comejv/ubac/hardware/BOM_Main Board_Schematic Main_2026-02-19.csv

No. | Quantity | Comment | Designator | Footprint | Value | Tolerance
1 | 2 | 100nF | C1,C3 | C0805 | 100nF | ±10%
2 | 1 | 1uF | C2 | C0805 | 1uF | ±10%
3 | 1 | 1729128 | CN1 | CONN-TH_2P-P5.08_1729128
4 | 1 | PM254V-11-03-H85 | H1 | HDR-TH_3P-P2.54-V-F
5 | 1 | MBT3904DW1T1G | Q1 | SOT-363_L2.0-W1.3-P0.65-LS2.1-TL
6 | 3 | 4.7kΩ | R1,R2,R18 | R0805 | 4.7kΩ | ±1%
7 | 1 | 220Ω | R3 | R0805 | 220Ω | ±1%
8 | 4 | 100kΩ | R4,R5,R6,R7 | R0805 | 100kΩ | ±1%
9 | 10 | 56kΩ | R8,R9,R10,R11,R12,R13,R14,R15,R16,R17 | R0805 | 56kΩ | ±0.1%
10 | 2 | 100Ω | R19,R20 | R0805 | 100Ω | ±1%
11 | 1 | 180Ω | R21 | R0805 | 180Ω | ±1%
12 | 1 | 1kΩ | R22 | R0805 | 1kΩ | ±5%
13 | 1 | GL5539 | R23 | RES-TH_L5.1-W4.3-P3.40-D0.5
14 | 1 | 10kΩ | R24 | R0805 | 10kΩ | ±1%
15 | 2 | ZX-PM2.54-1-20PY | U1,U2 | HDR-TH_20P-P2.54-V-F
16 | 1 | ADS1115IDGSR | U3 | MSOP-10_L3.0-W3.0-P0.50-LS5.0-BL
17 | 1 | CD74HC4067SM96 | U4 | SSOP-24_L8.1-W5.3-P0.65-LS7.8-BL
18 | 1 | HX FH254-02-10-W-H8.5 right angle pin header | U5 | HDR-TH_20P-P2.54-H-F-R2-C10-S2.54-W12.7
19 | 1 | DS18B20 | U6 | TO-92-3_L4.5-W3.5-P1.27-L |  | ±0.4℃
20 | 1 | XL-B2020RGBA-HF | U7 | LED-SMD_4P-L2.1-W2.1-P1.0-BL
21 | 1 | MX126-5.0-03P-GN01-Cu-S-A | U8 | CONN-TH_3P-P5.00_MAX_MX126-5.0-GN01-03P-CU-S-A
22 | 1 | DC-050-20 | U9 | DC-IN-SMD_DC-050-20A
23 | 1 | K7805-1000R3 | U10 | PWRM-TH_YLPTEC_K78XX-1000R3
