comejv/ubac/hardware/SCH_Schematic Main_2026-02-19.pdf

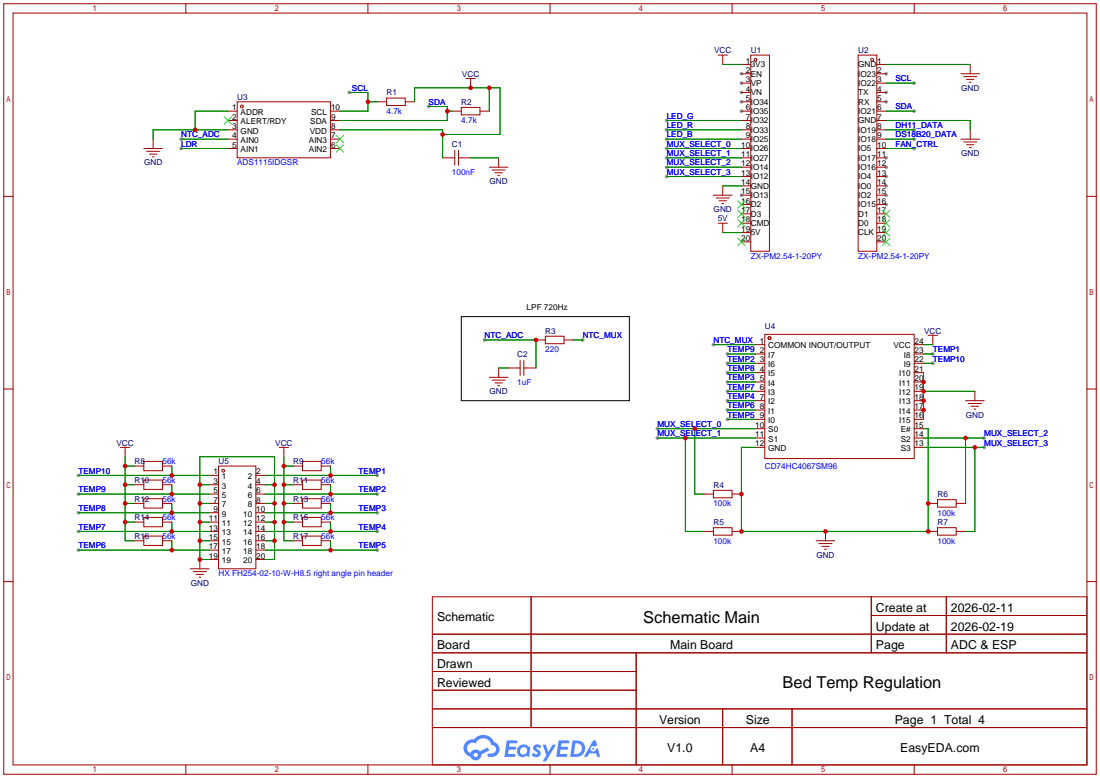
[picture p1: page 1]

Schematic | Schematic Main | Create at | 2026-02-11

Update at | 2026-02-19

Board | Main Board | Page | ADC & ESP
Drawn | | Bed Temp Regulation
Reviewed

Version | Size | Page 1 Total 4
V1.0 | A4 | EasyEDA.com

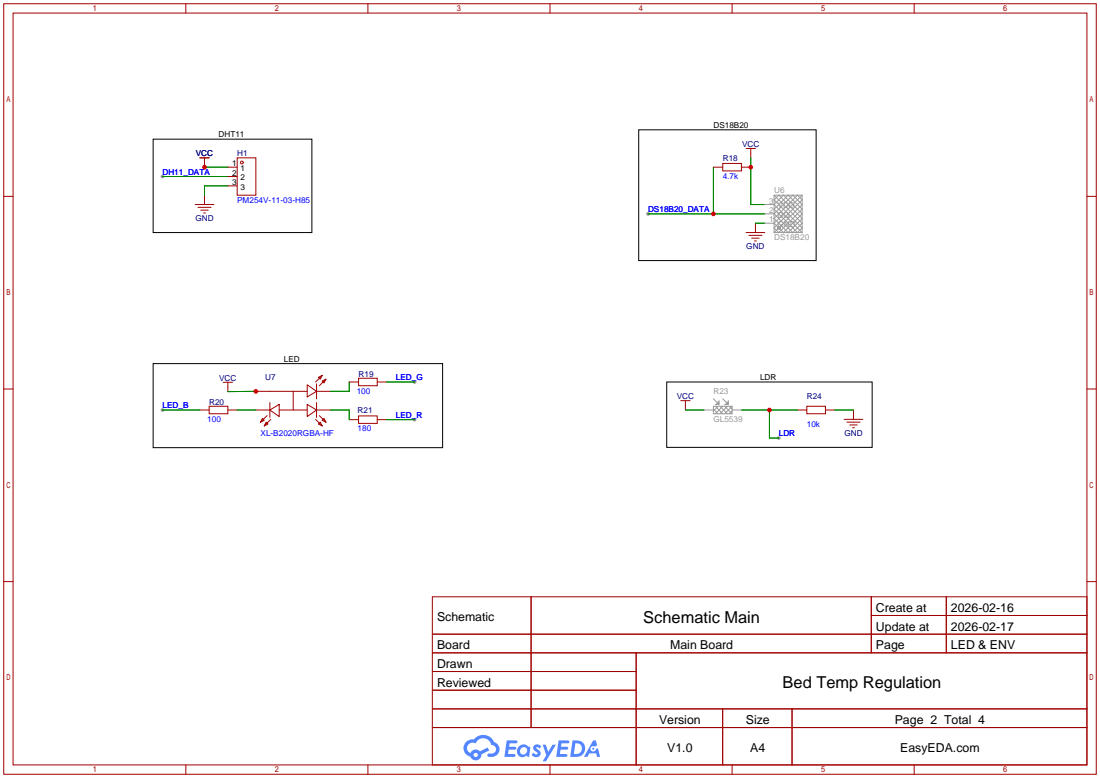
[picture p2: page 2]

Schematic | Schematic Main | Create at | 2026-02-16

Update at | 2026-02-17

Board | Main Board | Page | LED & ENV
Drawn | | Bed Temp Regulation
Reviewed

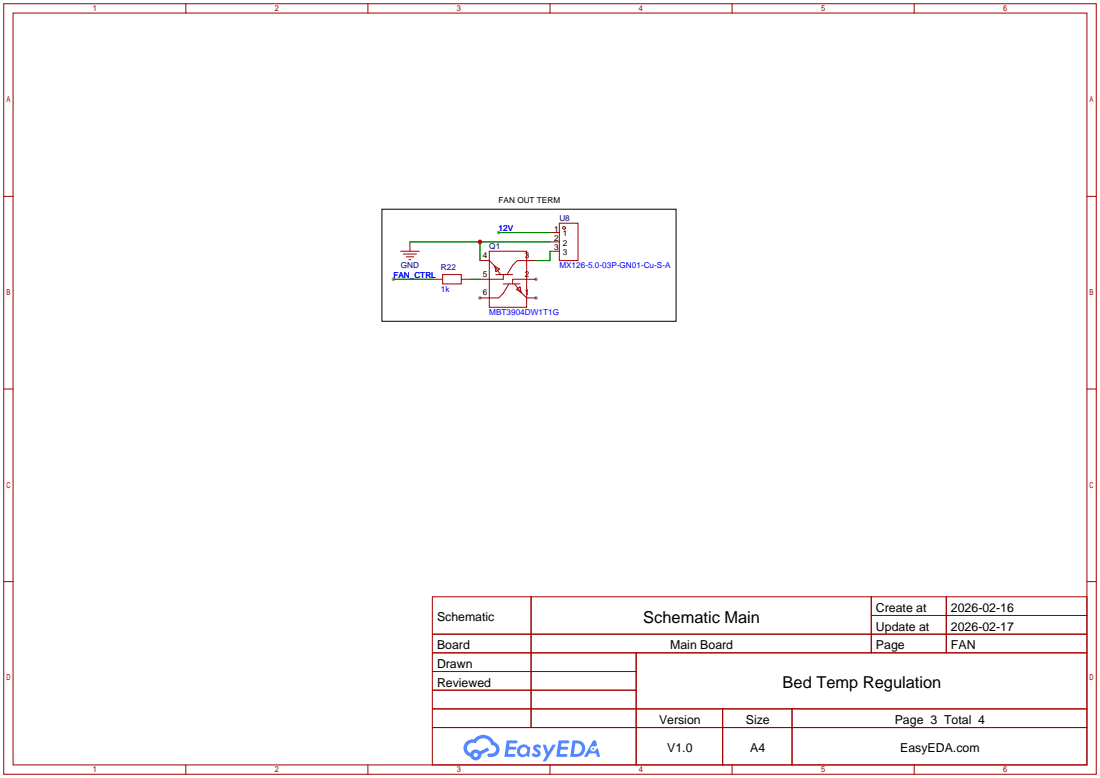
[picture p3: page 3]

Schematic | Schematic Main | Create at | 2026-02-16

Update at | 2026-02-17

Board | Main Board | Page | FAN
Drawn | | Bed Temp Regulation
Reviewed

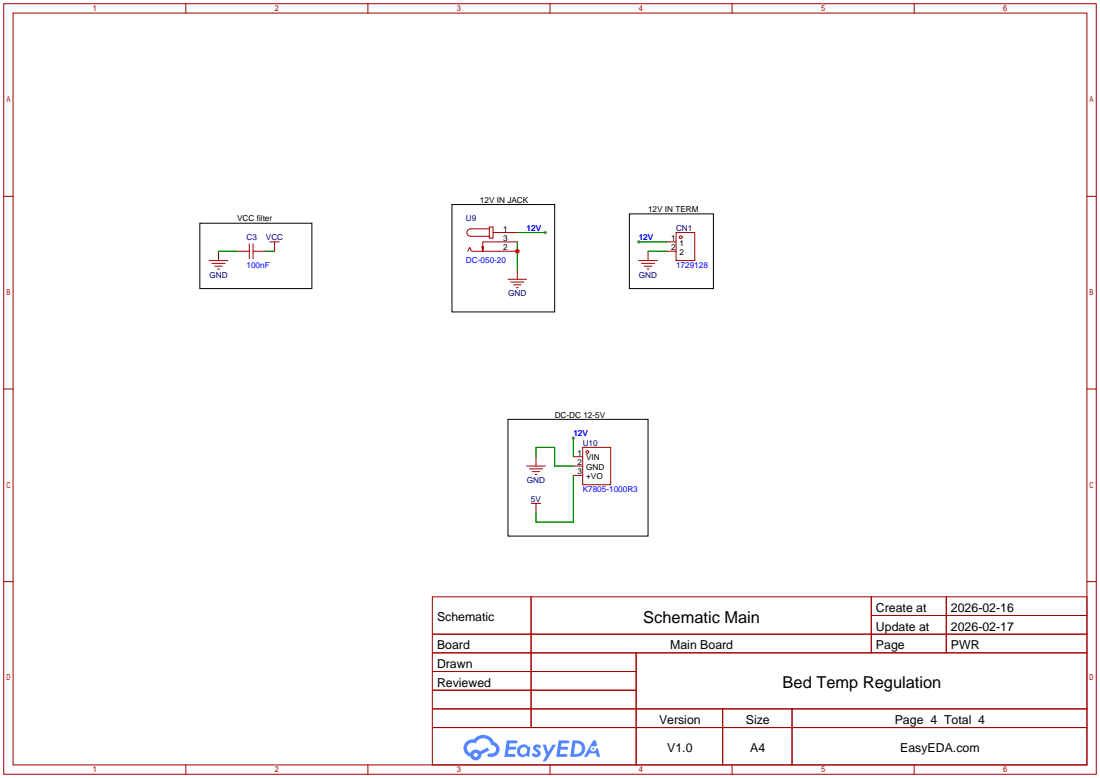
[picture p4: page 4]

Schematic | Schematic Main | Create at | 2026-02-16

Update at | 2026-02-17

Board | Main Board | Page | PWR
Drawn | | Bed Temp Regulation
Reviewed
