comejv/ubac/(list of files, drawings)

Other design files:
hardware/ProPrj_Bed Temp Regulation_2026-02-19.epro
