comejv/ubac/main/src/drivers/ntc_sensor.c

/*
 * UBAC: NTC Sensor Reading.
 * Copyright (C) 2026 Côme VINCENT
 *
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
 * You should have received a copy of the GNU General Public License
 * along with this program.  If not, see <https://www.gnu.org/licenses/>.
 */

#include "drivers/ntc_sensor.h"
#include "drivers/ads1115.h"
#include "drivers/mux.h"
#include "freertos/FreeRTOS.h"
#include "freertos/task.h"
#include <math.h>

// --- NTC Constants ---
#define R_DIVIDER 56000.0f
#define VREF_RAIL 3.3f   // Voltage supplying the NTC divider

// --- Steinhart-Hart Coefficients (R in ohms, T in kelvin) ---
#define SH_A 8.954641936e-4f
#define SH_B 2.034215141e-4f
#define SH_C 7.639241707e-8f

static float convert_raw_to_celsius(int16_t raw_adc)
{
  // Single-ended should be >= 0. Allow 0 (near GND) as valid.
  if (raw_adc < 0)
  {
    return NTC_INVALID_TEMP;
  }

  float voltage = (float) raw_adc * ADS_LSB_4V;

  // Guard: divider math explodes near VREF_RAIL
  if (voltage <= 0.001F || voltage >= (VREF_RAIL - 0.01F))
  {
    return NTC_INVALID_TEMP;
  }

  float r_ntc = (voltage * R_DIVIDER) / (VREF_RAIL - voltage);
  if (r_ntc <= 0.0F)
  {
    return NTC_INVALID_TEMP;
  }

  float lnR = logf(r_ntc);
  float invT = SH_A + (SH_B * lnR) + (SH_C * lnR * lnR * lnR);
  if (invT <= 0.0F)
  {
    return NTC_INVALID_TEMP;
  }

  float temp_k = 1.0F / invT;
  return temp_k - 273.15F;
}

esp_err_t ntc_get_temp_celsius(uint8_t channel, float *out_temp)
{
  if (!out_temp)
    return ESP_ERR_INVALID_ARG;

  mux_set_channel(channel);

  // Short delay for voltage stabilization after mux switch
  vTaskDelay(pdMS_TO_TICKS(10));

  // Trigger and read single-shot
  int16_t raw_val = 0;
  esp_err_t err = ads1115_read_raw(&raw_val, ADS1115_MUX_AIN0);
  if (err != ESP_OK)
  {
    return err;
  }

  *out_temp = convert_raw_to_celsius(raw_val);
  return (*out_temp == NTC_INVALID_TEMP) ? ESP_FAIL : ESP_OK;
}
