comejv/ubac/main/src/app/ntc_history.c

/*
 * UBAC: Temperature History Management.
 * Copyright (C) 2026 Côme VINCENT
 *
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
 * You should have received a copy of the GNU General Public License
 * along with this program.  If not, see <https://www.gnu.org/licenses/>.
 */

#include "app/ntc_history.h"

#include "esp_log.h"
#include "esp_partition.h"
#include "esp_rom_crc.h"
#include "freertos/FreeRTOS.h"
#include "freertos/semphr.h"

#include <inttypes.h>
#include <math.h>
#include <stddef.h>
#include <string.h>
#include <time.h>

#define STORAGE_PARTITION_LABEL   "storage"
#define STORAGE_PARTITION_SUBTYPE 0x99

#define SECTOR_SIZE     4096u
#define SECTOR_HDR_SIZE 64u

// On-flash record layout is 64 bytes.
#define RECORD_SIZE 64u

// Compute dynamic padding required for exactly 64 bytes.
#define RECORD_PAYLOAD_SIZE (12 + (2 * NTC_CHANNELS_COUNT) + 2 + 2)
#if RECORD_PAYLOAD_SIZE > 64
#error "NTC_CHANNELS_COUNT too large for 64-byte record"
#endif
#define RECORD_PADDING (64 - RECORD_PAYLOAD_SIZE)

#define RECORDS_PER_SECTOR ((SECTOR_SIZE - SECTOR_HDR_SIZE) / RECORD_SIZE)
#define RAM_BUFFER_RECORDS 16

#define SECTOR_MAGIC   0x53454354u   // 'SECT'
#define FORMAT_VERSION 2u

static const char *TAG = "NTC_HISTORY";

typedef struct __attribute__((packed))
{
  uint32_t magic;       // SECTOR_MAGIC
  uint32_t version;     // FORMAT_VERSION
  uint32_t seq_start;   // sequence number for first record in sector
  uint32_t hdr_crc32;   // CRC32 over version+seq_start
  uint8_t pad[SECTOR_HDR_SIZE - 16];
} sector_hdr_t;

_Static_assert(sizeof(sector_hdr_t) == SECTOR_HDR_SIZE, "sector_hdr_t size");

typedef struct __attribute__((packed))
{
  uint32_t seq;         // monotonic
  uint32_t timestamp;   // unix seconds
  int16_t temps_cC[NTC_CHANNELS_COUNT];
  int16_t room_temp_cC;
  int16_t humidity_cRH;
#if RECORD_PADDING > 0
  uint8_t pad[RECORD_PADDING];
#endif
  uint32_t rec_crc32;   // CRC over everything up to this struct member
} record_flash_t;

_Static_assert(sizeof(record_flash_t) == RECORD_SIZE, "record_flash_t size");

typedef struct
{
  uint32_t timestamp;
  int16_t temps_cC[NTC_CHANNELS_COUNT];
  int16_t room_temp_cC;
  int16_t humidity_cRH;
} record_ram_t;

typedef struct
{
  uint32_t sector_idx;
  uint32_t seq_start;
} sector_info_t;

static const esp_partition_t *s_part = NULL;
static SemaphoreHandle_t s_lock = NULL;

static uint32_t s_sector_count = 0;
static uint32_t s_cur_sector = 0;
static uint32_t s_cur_slot = 0;
static uint32_t s_last_seq = 0;
static bool s_ready = false;

static record_ram_t s_ram_buf[RAM_BUFFER_RECORDS];
static size_t s_ram_count = 0;

static uint32_t compute_crc32(const void *data, size_t len)
{
  return esp_rom_crc32_le(0, (const uint8_t *) data, len);
}

static uint32_t get_sector_offset(uint32_t sector_idx)
{
  return sector_idx * SECTOR_SIZE;
}

static uint32_t get_record_offset(uint32_t sector_idx, uint32_t slot_idx)
{
  return get_sector_offset(sector_idx) + SECTOR_HDR_SIZE +
         (slot_idx * RECORD_SIZE);
}

static int16_t float_to_cC(float temp_c)
{
  if (isnan(temp_c) || isinf(temp_c))
  {
    return INT16_MIN;
  }

  long v = lroundf(temp_c * (float) NTC_TEMP_SCALE);
  if (v > INT16_MAX)
    return INT16_MAX;
  if (v < INT16_MIN + 1)
    return INT16_MIN + 1;
  return (int16_t) v;
}

static bool read_sector_hdr(uint32_t sector_idx, sector_hdr_t *out_hdr)
{
  if (esp_partition_read(s_part, get_sector_offset(sector_idx), out_hdr,
                         sizeof(*out_hdr)) != ESP_OK)
  {
    return false;
  }

  if (out_hdr->magic != SECTOR_MAGIC || out_hdr->version != FORMAT_VERSION)
  {
    return false;
  }

  uint32_t expected = compute_crc32(&out_hdr->version, 8);
  return expected == out_hdr->hdr_crc32;
}

static bool read_record(uint32_t sector_idx, uint32_t slot_idx,
                        record_flash_t *out_rec)
{
  return esp_partition_read(s_part, get_record_offset(sector_idx, slot_idx),
                            out_rec, sizeof(*out_rec)) == ESP_OK;
}

static bool record_is_empty(const record_flash_t *r)
{
  return r->seq == 0xFFFFFFFFu;
}

static bool record_is_valid(const record_flash_t *r)
{
  if (r->seq == 0 || r->seq == 0xFFFFFFFFu)
  {
    return false;
  }

  uint32_t expected = compute_crc32(r, offsetof(record_flash_t, rec_crc32));
  return expected == r->rec_crc32;
}

static esp_err_t write_sector_hdr(uint32_t sector_idx, uint32_t seq_start)
{
  sector_hdr_t hdr;
  memset(&hdr, 0xFF, sizeof(hdr));

  hdr.magic = SECTOR_MAGIC;
  hdr.version = FORMAT_VERSION;
  hdr.seq_start = seq_start;
  hdr.hdr_crc32 = compute_crc32(&hdr.version, 8);

  return esp_partition_write(s_part, get_sector_offset(sector_idx), &hdr,
                             sizeof(hdr));
}

static size_t collect_sectors(sector_info_t *out, size_t max)
{
  size_t n = 0;
  for (uint32_t i = 0; i < s_sector_count && n < max; i++)
  {
    sector_hdr_t hdr;
    if (!read_sector_hdr(i, &hdr))
    {
      continue;
    }
    out[n++] = (sector_info_t) {.sector_idx = i, .seq_start = hdr.seq_start};
  }
  return n;
}

static void sort_sectors_by_seq_start(sector_info_t *s, size_t n)
{
  for (size_t i = 0; i < n; i++)
  {
    size_t best = i;
    for (size_t j = i + 1; j < n; j++)
    {
      if (s[j].seq_start < s[best].seq_start)
        best = j;
    }
    if (best != i)
    {
      sector_info_t tmp = s[i];
      s[i] = s[best];
      s[best] = tmp;
    }
  }
}

static esp_err_t advance_sector(void)
{
  uint32_t next = (s_cur_sector + 1) % s_sector_count;

  esp_err_t err =
      esp_partition_erase_range(s_part, get_sector_offset(next), SECTOR_SIZE);
  if (err != ESP_OK)
    return err;

  err = write_sector_hdr(next, s_last_seq + 1);
  if (err != ESP_OK)
    return err;

  s_cur_sector = next;
  s_cur_slot = 0;
  return ESP_OK;
}

static void scan_current_sector_tail(void)
{
  for (uint32_t slot = 0; slot < RECORDS_PER_SECTOR; slot++)
  {
    record_flash_t r;
    if (!read_record(s_cur_sector, slot, &r))
    {
      s_cur_slot = RECORDS_PER_SECTOR;
      return;
    }

    if (record_is_empty(&r))
    {
      s_cur_slot = slot;
      return;
    }

    if (!record_is_valid(&r))
    {
      s_cur_slot = RECORDS_PER_SECTOR;
      return;
    }

    if (r.seq > s_last_seq)
    {
      s_last_seq = r.seq;
    }
  }

  s_cur_slot = RECORDS_PER_SECTOR;
}

static esp_err_t write_one_record(uint32_t timestamp,
                                  const int16_t temps_cC[NTC_CHANNELS_COUNT],
                                  int16_t room_temp_cC,
                                  int16_t humidity_cRH)
{
  if (s_cur_slot >= RECORDS_PER_SECTOR)
  {
    esp_err_t err = advance_sector();
    if (err != ESP_OK)
      return err;
  }

  record_flash_t rec;
  memset(&rec, 0xFF, sizeof(rec));

  rec.seq = s_last_seq + 1;
  rec.timestamp = timestamp;
  memcpy(rec.temps_cC, temps_cC, sizeof(rec.temps_cC));
  rec.room_temp_cC = room_temp_cC;
  rec.humidity_cRH = humidity_cRH;
  rec.rec_crc32 = compute_crc32(&rec, offsetof(record_flash_t, rec_crc32));

  uint32_t off = get_record_offset(s_cur_sector, s_cur_slot);

  esp_err_t err = esp_partition_write(s_part, off, &rec, sizeof(rec));
  if (err != ESP_OK)
    return err;

  s_last_seq = rec.seq;
  s_cur_slot++;
  return ESP_OK;
}

// Caller must hold s_lock!
static esp_err_t flush_locked(void)
{
  esp_err_t last_err = ESP_OK;
  size_t i;
  for (i = 0; i < s_ram_count; i++)
  {
    esp_err_t err = write_one_record(s_ram_buf[i].timestamp, s_ram_buf[i].temps_cC,
                                     s_ram_buf[i].room_temp_cC, s_ram_buf[i].humidity_cRH);
    if (err != ESP_OK)
    {
      ESP_LOGE(TAG, "write_one_record failed: %s", esp_err_to_name(err));
      last_err = err;
      break;
    }
  }

  if (i > 0)
  {
    size_t remaining = s_ram_count - i;
    if (remaining > 0)
    {
      memmove(s_ram_buf, &s_ram_buf[i], remaining * sizeof(record_ram_t));
    }
    s_ram_count = remaining;
  }
  return last_err;
}

esp_err_t ntc_history_init(void)
{
  s_part = esp_partition_find_first(ESP_PARTITION_TYPE_DATA,
                                    STORAGE_PARTITION_SUBTYPE,
                                    STORAGE_PARTITION_LABEL);
  if (!s_part)
  {
    ESP_LOGE(TAG, "Could not find storage partition, will not log NTC history");
    s_ready = false;
    return ESP_ERR_NOT_FOUND;
  }

  if (s_part->erase_size != SECTOR_SIZE)
  {
    ESP_LOGE(TAG, "Unexpected erase size=%" PRIu32, s_part->erase_size);
    s_ready = false;
    return ESP_ERR_INVALID_STATE;
  }

  s_sector_count = s_part->size / SECTOR_SIZE;
  if (s_sector_count == 0)
  {
    ESP_LOGE(TAG, "Partition too small");
    s_ready = false;
    return ESP_ERR_INVALID_SIZE;
  }

  if (!s_lock)
  {
    s_lock = xSemaphoreCreateMutex();
  }

  xSemaphoreTake(s_lock, portMAX_DELAY);

  bool found_any = false;
  uint32_t best_sector = 0;
  uint32_t best_seq_start = 0;

  for (uint32_t i = 0; i < s_sector_count; i++)
  {
    sector_hdr_t hdr;
    if (!read_sector_hdr(i, &hdr))
      continue;

    if (!found_any || hdr.seq_start > best_seq_start)
    {
      found_any = true;
      best_sector = i;
      best_seq_start = hdr.seq_start;
    }
  }

  s_last_seq = 0;
  s_cur_sector = 0;
  s_cur_slot = 0;

  if (!found_any)
  {
    ESP_LOGI(TAG, "No valid log (format v%u); initializing sector 0",
             (unsigned) FORMAT_VERSION);

    esp_err_t err = esp_partition_erase_range(s_part, get_sector_offset(0), SECTOR_SIZE);
    if (err != ESP_OK)
    {
      xSemaphoreGive(s_lock);
      return err;
    }
    err = write_sector_hdr(0, 1);
    if (err != ESP_OK)
    {
      xSemaphoreGive(s_lock);
      return err;
    }
  }
  else
  {
    s_cur_sector = best_sector;
    s_last_seq = best_seq_start - 1;
    scan_current_sector_tail();

    if (s_cur_slot >= RECORDS_PER_SECTOR)
    {
      esp_err_t err = advance_sector();
      if (err != ESP_OK)
      {
        xSemaphoreGive(s_lock);
        return err;
      }
    }
  }

  s_ready = true;

  ESP_LOGI(TAG,
           "Init ok: sectors=%" PRIu32 " records/sector=%u capacity=%u "
           "cur_sector=%" PRIu32 " cur_slot=%" PRIu32 " last_seq=%" PRIu32,
           s_sector_count, (unsigned) RECORDS_PER_SECTOR,
           (unsigned) ntc_history_get_capacity(), s_cur_sector, s_cur_slot,
           s_last_seq);

  xSemaphoreGive(s_lock);
  return ESP_OK;
}

esp_err_t ntc_history_add_record(const float temps[NTC_CHANNELS_COUNT], float room_temp, float humidity)
{
  if (!s_ready)
    return ESP_ERR_INVALID_STATE;

  record_ram_t r;
  r.timestamp = (uint32_t) time(NULL);
  for (int i = 0; i < NTC_CHANNELS_COUNT; i++)
  {
    r.temps_cC[i] = float_to_cC(temps[i]);
  }
  r.room_temp_cC = float_to_cC(room_temp);
  r.humidity_cRH = float_to_cC(humidity);

  xSemaphoreTake(s_lock, portMAX_DELAY);

  esp_err_t err = ESP_OK;
  if (s_ram_count >= RAM_BUFFER_RECORDS)
  {
    err = flush_locked();
  }

  if (s_ram_count < RAM_BUFFER_RECORDS)
  {
    s_ram_buf[s_ram_count++] = r;
  }

  if (s_ram_count >= RAM_BUFFER_RECORDS)
  {
    err = flush_locked();
  }

  xSemaphoreGive(s_lock);
  return err;
}

esp_err_t ntc_history_flush(void)
{
  if (!s_ready)
    return ESP_ERR_INVALID_STATE;

  xSemaphoreTake(s_lock, portMAX_DELAY);
  esp_err_t err = flush_locked();
  xSemaphoreGive(s_lock);
  return err;
}

size_t ntc_history_get_capacity(void)
{
  if (!s_part)
    return 0;
  return (size_t) s_sector_count * (size_t) RECORDS_PER_SECTOR;
}

size_t ntc_history_iterate(uint32_t since_ts, size_t max,
                           ntc_history_iter_cb_t cb, void *ctx)
{
  if (!s_ready)
    return 0;
  if (max == 0)
    max = (size_t) -1;

  xSemaphoreTake(s_lock, portMAX_DELAY);

  sector_info_t *sectors = malloc(s_sector_count * sizeof(sector_info_t));
  if (!sectors)
  {
    xSemaphoreGive(s_lock);
    return 0;
  }

  size_t nsec = collect_sectors(sectors, s_sector_count);
  sort_sectors_by_seq_start(sectors, nsec);

  xSemaphoreGive(s_lock);

  size_t emitted = 0;

  uint8_t *sec_buf = malloc(SECTOR_SIZE);
  if (!sec_buf)
  {
    free(sectors);
    return 0;
  }

  for (size_t si = 0; si < nsec; si++)
  {
    uint32_t sector = sectors[si].sector_idx;

    if (esp_partition_read(s_part, get_sector_offset(sector), sec_buf,
                           SECTOR_SIZE) != ESP_OK)
    {
      continue;
    }

    for (uint32_t slot = 0; slot < RECORDS_PER_SECTOR; slot++)
    {
      record_flash_t *rf = (record_flash_t *) (sec_buf + SECTOR_HDR_SIZE +
                                               (slot * RECORD_SIZE));

      if (record_is_empty(rf) || !record_is_valid(rf))
      {
        break;
      }

      if (since_ts != 0 && rf->timestamp < since_ts)
        continue;

      ntc_record_t r;
      r.timestamp = rf->timestamp;
      memcpy(r.temps_cC, rf->temps_cC, sizeof(r.temps_cC));
      r.room_temp_cC = rf->room_temp_cC;
      r.humidity_cRH = rf->humidity_cRH;

      if (cb && !cb(&r, ctx))
      {
        goto done;
      }

      emitted++;
      if (emitted >= max)
        goto done;
    }
  }

done:
  free(sec_buf);
  free(sectors);
  return emitted;
}

typedef struct
{
  size_t count;
} count_ctx_t;

static bool count_cb(const ntc_record_t *rec, void *ctx)
{
  (void) rec;
  count_ctx_t *c = (count_ctx_t *) ctx;
  c->count++;
  return true;
}

typedef struct
{
  ntc_record_t *out;
  size_t max;
  size_t skip;
  size_t written;
  size_t seen;
} copy_ctx_t;

static bool copy_cb(const ntc_record_t *rec, void *ctx)
{
  copy_ctx_t *c = (copy_ctx_t *) ctx;

  if (c->seen++ < c->skip)
    return true;
  if (c->written >= c->max)
    return false;

  c->out[c->written++] = *rec;
  return c->written < c->max;
}

size_t ntc_history_get_records(ntc_record_t *out_records, size_t max_records)
{
  if (!s_ready || !out_records || max_records == 0)
    return 0;

  count_ctx_t cc = {.count = 0};
  (void) ntc_history_iterate(0, 0, count_cb, &cc);

  size_t total = cc.count;
  size_t skip = (total > max_records) ? (total - max_records) : 0;

  copy_ctx_t cx = {
      .out = out_records,
      .max = max_records,
      .skip = skip,
      .written = 0,
      .seen = 0,
  };

  (void) ntc_history_iterate(0, 0, copy_cb, &cx);
  return cx.written;
}

esp_err_t ntc_history_erase_all(void)
{
  if (!s_part)
    return ESP_ERR_INVALID_STATE;
  if (!s_lock)
    s_lock = xSemaphoreCreateMutex();

  xSemaphoreTake(s_lock, portMAX_DELAY);

  esp_err_t err = esp_partition_erase_range(s_part, 0, s_part->size);
  if (err != ESP_OK)
  {
    xSemaphoreGive(s_lock);
    return err;
  }

  err = write_sector_hdr(0, 1);
  if (err != ESP_OK)
  {
    xSemaphoreGive(s_lock);
    return err;
  }

  s_cur_sector = 0;
  s_cur_slot = 0;
  s_last_seq = 0;
  s_ram_count = 0;
  s_ready = true;

  xSemaphoreGive(s_lock);
  return ESP_OK;
}
