comejv/ubac/main/src/web_server.c

/*
 * UBAC:web_server.c for ESP32 to serve web pages.
 * Copyright (C) 2026 Côme VINCENT
 *
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
 * You should have received a copy of the GNU General Public License
 * along with this program.  If not, see <https://www.gnu.org/licenses/>.
 */

#include "web_server.h"
#include "esp_http_server.h"
#include "esp_log.h"
#include "esp_system.h"
#include "esp_wifi.h"
#include "ntc_history.h"
#include "wifi_app.h"
#include <inttypes.h>
#include <math.h>
#include <stddef.h>
#include <string.h>
#include <sys/param.h>
#include <sys/time.h>

static const char *TAG = "WEB_SERVER";
static httpd_handle_t server = NULL;

/* HTML Content */
extern const uint8_t config_html_start[] asm("_binary_config_html_start");
extern const uint8_t config_html_end[] asm("_binary_config_html_end");

extern const uint8_t dashboard_html_start[] asm("_binary_dashboard_html_start");
extern const uint8_t dashboard_html_end[] asm("_binary_dashboard_html_end");

/* Handler for the root URL */
static esp_err_t index_get_handler(httpd_req_t *req)
{
  httpd_resp_set_type(req, "text/html");

  // Check if we are connected to STA
  wifi_ap_record_t ap_info;
  if (esp_wifi_sta_get_ap_info(&ap_info) == ESP_OK)
  {
    const char *resp = (const char *) dashboard_html_start;
    size_t resp_len = strlen(resp);
    size_t chunk_size = 2048;
    size_t offset = 0;

    while (offset < resp_len)
    {
      size_t len = resp_len - offset;
      if (len > chunk_size)
      {
        len = chunk_size;
      }
      if (httpd_resp_send_chunk(req, resp + offset, len) != ESP_OK)
      {
        return ESP_FAIL;
      }
      offset += len;
    }
    httpd_resp_send_chunk(req, NULL, 0);
  }
  else
  {
    httpd_resp_send(req, (const char *) config_html_start, HTTPD_RESP_USE_STRLEN);
  }
  return ESP_OK;
}

/* Handler for /history.json */
typedef struct
{
  httpd_req_t *req;
  size_t count;
  size_t skip;
  size_t seen;
} stream_ctx_t;

static bool history_stream_cb(const ntc_record_t *rec, void *ctx)
{
  stream_ctx_t *c = (stream_ctx_t *) ctx;

  if (c->seen < c->skip)
  {
    c->seen++;
    return true;
  }

  if (c->count == 0)
  {
    httpd_resp_sendstr_chunk(c->req, "[");
  }
  else
  {
    httpd_resp_sendstr_chunk(c->req, ",");
  }

  char buf[256];
  int len = snprintf(
      buf, sizeof(buf),
      "{\"t\":%" PRIu32 ",\"s\":%d,"
      "\"v\":[%d,%d,%d,%d,%d,%d,%d,%d,%d,%d]}",
      rec->timestamp, NTC_TEMP_SCALE, rec->temps_cC[0],
      rec->temps_cC[1], rec->temps_cC[2], rec->temps_cC[3],
      rec->temps_cC[4], rec->temps_cC[5], rec->temps_cC[6],
      rec->temps_cC[7], rec->temps_cC[8], rec->temps_cC[9]);

  httpd_resp_send_chunk(c->req, buf, len);
  c->count++;

  return true;
}

static esp_err_t history_get_handler(httpd_req_t *req)
{
  httpd_resp_set_type(req, "application/json");

  stream_ctx_t ctx = {
      .req = req,
      .count = 0,
      .skip = 0,
      .seen = 0,
  };

  size_t max = 1024;

  size_t actual_total = ntc_history_iterate(0, 0, NULL, NULL);
  if (actual_total > max)
  {
    ctx.skip = actual_total - max;
  }

  ntc_history_iterate(0, 0, history_stream_cb, &ctx);

  if (ctx.count == 0)
  {
    httpd_resp_send(req, "[]", 2);
  }
  else
  {
    httpd_resp_sendstr_chunk(req, "]");
    httpd_resp_send_chunk(req, NULL, 0);
  }

  return ESP_OK;
}

/* Handler for the scan URL */
static esp_err_t scan_get_handler(httpd_req_t *req)
{
  char *json = wifi_app_scan();
  if (json)
  {
    httpd_resp_set_type(req, "application/json");
    httpd_resp_send(req, json, HTTPD_RESP_USE_STRLEN);
    free(json);
  }
  else
  {
    httpd_resp_send_500(req);
  }
  return ESP_OK;
}

/* Async Connection Task */
typedef struct
{
  char ssid[32];
  char password[64];
} wifi_creds_t;

static void connect_task(void *pvParameters)
{
  wifi_creds_t *creds = (wifi_creds_t *) pvParameters;
  vTaskDelay(pdMS_TO_TICKS(1000));   // Delay to allow HTTP response to flush
  wifi_app_connect_sta(creds->ssid, creds->password);
  free(creds);
  vTaskDelete(NULL);
}

/* Handler for the connect POST */
static esp_err_t connect_post_handler(httpd_req_t *req)
{
  char buf[100];
  int ret;
  size_t remaining = req->content_len;

  if (remaining >= sizeof(buf))
  {
    httpd_resp_send_500(req);
    return ESP_FAIL;
  }

  ret = httpd_req_recv(req, buf, remaining);
  if (ret <= 0)
  {
    if (ret == HTTPD_SOCK_ERR_TIMEOUT)
    {
      httpd_resp_send_408(req);
    }
    return ESP_FAIL;
  }
  buf[ret] = '\0';

  wifi_creds_t *creds = malloc(sizeof(wifi_creds_t));
  if (!creds)
  {
    httpd_resp_send_500(req);
    return ESP_FAIL;
  }
  memset(creds, 0, sizeof(wifi_creds_t));

  char *ssid_ptr = strstr(buf, "ssid=");
  char *pass_ptr = strstr(buf, "password=");

  if (ssid_ptr)
  {
    ssid_ptr += 5;
    char *end = strchr(ssid_ptr, '&');
    if (!end)
      end = buf + strlen(buf);
    int len = MIN(end - ssid_ptr, sizeof(creds->ssid) - 1);
    strncpy(creds->ssid, ssid_ptr, len);
  }

  if (pass_ptr)
  {
    pass_ptr += 9;
    char *end = strchr(pass_ptr, '&');
    if (!end)
      end = buf + strlen(buf);
    int len = MIN(end - pass_ptr, sizeof(creds->password) - 1);
    strncpy(creds->password, pass_ptr, len);
  }

  ESP_LOGI(TAG, "Received Connect Request: SSID='%s'", creds->ssid);

  httpd_resp_send(req, "Connecting... Please reconnect to the new network.", HTTPD_RESP_USE_STRLEN);

  // Spawn task to handle connection
  xTaskCreate(connect_task, "connect_task", 4096, creds, 5, NULL);

  return ESP_OK;
}

/* Handler for /fake_history.json */
static esp_err_t fake_history_get_handler(httpd_req_t *req)
{
  httpd_resp_set_type(req, "application/json");
  httpd_resp_sendstr_chunk(req, "[");

  uint32_t now = (uint32_t) time(NULL);
  if (now < 1700000000)
    now = 1739980800;   // Fallback to Feb 2025 if RTC not set

  for (int i = 0; i < 100; i++)
  {
    uint32_t t = now - (100 - i) * 120;
    char buf[256];
    int vals[NTC_CHANNELS_COUNT];

    for (int ch = 0; ch < NTC_CHANNELS_COUNT; ch++)
    {
      float base = 25.0f + ch * 2.0f;
      float amplitude = 5.0f;
      float val = base + amplitude * sinf((float) (t % 3600) / 3600.0f * 2.0f * M_PI + (ch * 0.5f));
      vals[ch] = (int) (val * NTC_TEMP_SCALE);
    }

    int len = snprintf(
        buf, sizeof(buf),
        "%s{\"t\":%" PRIu32 ",\"s\":%d,\"v\":[%d,%d,%d,%d,%d,%d,%d,%d,%d,%d]}",
        (i == 0) ? "" : ",", t, NTC_TEMP_SCALE,
        vals[0], vals[1], vals[2], vals[3], vals[4],
        vals[5], vals[6], vals[7], vals[8], vals[9]);

    httpd_resp_send_chunk(req, buf, len);
  }

  httpd_resp_sendstr_chunk(req, "]");
  httpd_resp_send_chunk(req, NULL, 0);

  return ESP_OK;
}

/* Handler for the reset wifi POST */
static esp_err_t reset_wifi_post_handler(httpd_req_t *req)
{
  ESP_LOGI(TAG, "Clearing WiFi Station credentials and Restarting...");
  httpd_resp_send(req, "OK. WiFi credentials cleared. Restarting...", 44);

  vTaskDelay(pdMS_TO_TICKS(1000));

  // Clear only STA config instead of full restore
  wifi_config_t wifi_config = {0};
  esp_wifi_set_config(WIFI_IF_STA, &wifi_config);

  esp_restart();
  return ESP_OK;
}

static const httpd_uri_t index_uri = {
    .uri = "/",
    .method = HTTP_GET,
    .handler = index_get_handler,
    .user_ctx = NULL};

static const httpd_uri_t history_uri = {
    .uri = "/history.json",
    .method = HTTP_GET,
    .handler = history_get_handler,
    .user_ctx = NULL};

static const httpd_uri_t fake_history_uri = {
    .uri = "/fake_history.json",
    .method = HTTP_GET,
    .handler = fake_history_get_handler,
    .user_ctx = NULL};

static const httpd_uri_t reset_wifi_uri = {
    .uri = "/reset_wifi",
    .method = HTTP_POST,
    .handler = reset_wifi_post_handler,
    .user_ctx = NULL};

static const httpd_uri_t scan_uri = {
    .uri = "/scan",
    .method = HTTP_GET,
    .handler = scan_get_handler,
    .user_ctx = NULL};

static const httpd_uri_t connect_uri = {
    .uri = "/connect",
    .method = HTTP_POST,
    .handler = connect_post_handler,
    .user_ctx = NULL};

esp_err_t http_404_error_handler(httpd_req_t *req, httpd_err_code_t err)
{
  if (err == HTTPD_404_NOT_FOUND)
  {
    // Redirect to captive portal
    httpd_resp_set_status(req, "302 Found");
    httpd_resp_set_hdr(req, "Location", "http://192.168.4.1/");
    httpd_resp_send(req, NULL, 0);
    return ESP_OK;
  }
  return ESP_FAIL;
}

esp_err_t web_server_start(void)
{
  httpd_config_t config = HTTPD_DEFAULT_CONFIG();
  config.max_uri_handlers = 12;
  config.stack_size = 8192;   // Increase stack for scan handling

  ESP_LOGI(TAG, "Starting web server on port: '%d'", config.server_port);
  if (httpd_start(&server, &config) == ESP_OK)
  {
    httpd_register_uri_handler(server, &index_uri);
    httpd_register_uri_handler(server, &history_uri);
    httpd_register_uri_handler(server, &fake_history_uri);
    httpd_register_uri_handler(server, &reset_wifi_uri);
    httpd_register_uri_handler(server, &scan_uri);
    httpd_register_uri_handler(server, &connect_uri);
    // Register error handler for captive portal effect
    httpd_register_err_handler(server, HTTPD_404_NOT_FOUND, http_404_error_handler);
    return ESP_OK;
  }

  ESP_LOGI(TAG, "Error starting server!");
  return ESP_FAIL;
}
