comejv/ubac/main/src/drivers/ads1115.c

/*
 * UBAC:ads1115.c for ESP32 to read ADC values from a ADS1115 ADC.
 * Copyright (C) 2026 Côme VINCENT
 *
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
 * You should have received a copy of the GNU General Public License
 * along with this program.  If not, see <https://www.gnu.org/licenses/>.
 */

#include "drivers/ads1115.h"
#include "driver/i2c_master.h"
#include "drivers/i2c_manager.h"
#include "freertos/FreeRTOS.h"
#include "freertos/task.h"

static i2c_master_dev_handle_t s_ads1115_handle = NULL;

esp_err_t ads1115_init(void)
{
  i2c_device_config_t dev_cfg = {
      .dev_addr_length = I2C_ADDR_BIT_LEN_7,
      .device_address = ADS1115_ADDR,
      .scl_speed_hz = I2C_MASTER_FREQ_HZ,
  };

  return i2c_master_bus_add_device(i2c_manager_bus_handle, &dev_cfg, &s_ads1115_handle);
}

esp_err_t ads1115_read_raw(int16_t *out_raw, uint16_t mux)
{
  if (s_ads1115_handle == NULL)
  {
    return ESP_ERR_INVALID_STATE;
  }

  ADS1115_Config_Register config;
  config.raw = 0;
  config.fields.os = 1;            // Start conversion
  config.fields.mux = mux;         // Select channel
  config.fields.pga = 0b001;       // +/-4.096V
  config.fields.mode = 1;          // Single-shot
  config.fields.dr = 0b100;        // 128 SPS
  config.fields.comp_que = 0b11;   // Disable comparator

  // Write config (start single-shot)
  uint8_t config_data[3] = {
      ADS1115_REG_POINTER_CONFIG,
      config.bytes.msb,
      config.bytes.lsb,
  };

  esp_err_t err = i2c_master_transmit(
      s_ads1115_handle,
      config_data,
      sizeof(config_data),
      I2C_MASTER_TIMEOUT_MS);
  if (err != ESP_OK)
  {
    return err;
  }

  // Wait for conversion: 128 SPS => 7.8125ms
  vTaskDelay(pdMS_TO_TICKS(10));

  // Point to conversion register and read conversion (2 bytes, big-endian)
  uint8_t reg_ptr = ADS1115_REG_POINTER_CONV;
  uint8_t buf[2] = {0};
  err = i2c_master_transmit_receive(
      s_ads1115_handle,
      &reg_ptr,
      1,
      buf,
      sizeof(buf),
      I2C_MASTER_TIMEOUT_MS);
  if (err != ESP_OK)
  {
    return err;
  }

  if (out_raw != NULL)
  {
    *out_raw = (int16_t) ((buf[0] << 8) | buf[1]);
  }
  return ESP_OK;
}
