comejv/ubac/(commit log)

2026-02-19 fix(hardware): use comma for BOM separator
    [BOM_Main Board_Schematic Main_2026-02-19.csv]
2026-02-19 feat: implement wifi and history systems
    This update adds WiFi configuration with a captive portal and a memory-efficient NTC temperature history system. It includes flash-based record storage, streaming JSON serving to reduce memory pressure, and an optimized partition layout for 2MB flash devices. WiFi credentials are now explicitly persisted in NVS.
    [partitions.csv]
2026-02-20 fix(wifi_app): add ret check and remove unused headers
    [wifi_app.c]
2026-02-20 fix(dns_server): rework dns server & don't hardcode IP
    [dns_server.c]
2026-02-21 fix: correct flash size, wifi password security, and implement smart start logic
    [wifi_app.c]
2026-02-21 feat: migrate I2C driver to modern ESP-IDF v5.x master API
2026-02-21 feat: add temporary fake data generation and remote wifi reset to dashboard
    [fan_ctrl.c, web_server.c]
2026-02-21 fix: web server now sends chunked responses
    [web_server.c]
2026-02-21 fix: only answer to broadcast with expected request
    [udp_responder.c]
2026-02-21 fix: move default event loop creation to main
    [ubac_main.c, wifi_app.c]
2026-02-24 refactor: implement layering by abstraction layer
    - Create drivers/, net/, and app/ subdirectories in src/ and include/
    - Move files to their respective layer directories
    - Update include statements to use layered paths (e.g., #include "drivers/ads1115.h")
    - Update main/CMakeLists.txt with new source paths
2026-02-24 feat: move project constants to Kconfig
    - Add NTC sensor, I2C, and WiFi settings to Kconfig.projbuild
    - Update headers to use CONFIG_ macros instead of hardcoded defines
    - Ensure sdkconfig.h is included where needed
2026-02-24 docs: document coding conventions and apply formatting
    - Create CONVENTIONS.md to outline layering, naming, and error handling rules
    - Format all .c and .h files using clang-format according to .clang-format
    - Ensure project consistency with newly adopted standards
    [ads1115.c, dns_server.c, i2c_manager.c, i2c_manager.h, mux.c, mux.h, ntc_history.c]
2026-02-24 chore: track .clang-format file
2026-02-24 feat: refactor CPU monitoring
    - move rendering to client-side and add dynamic polling
    - Move CPU usage calculation from ESP32 to web dashboard to reduce jitter and server load
    - Update ESP32 to send raw runtime counters via JSON
    - Add CONFIG_CPU_MONITOR_POLL_MS to Kconfig for synchronized polling across C and JS
    - Fix dashboard layout issues and handle unpinned task core display
    - Improve WiFi reconnection logic and scan error handling
    - Clean up networking code and improve captive portal redirection
    [cpu_monitor.c, cpu_monitor.h, ubac_main.c, udp_responder.c, web_server.c, wifi_app.c]
2026-02-25 feat(led): add LED indications for system and Wi-Fi status
2026-02-25 feat(sntp): add SNTP support and room temperature/humidity logging
